jahaanb7/Orion/README.md

# Orion
Building a thrust-vector control rocket from scratch. It will include custom flight controller (useable for drones as well), thrust vector control mechanism, and our goal is for it to be actively stabilized and ascent ~30 meters into the air. 

Screenshot 2026-09-21 at 12 17 08 AM
Screenshot 2026-09-21 at 12 17 03 AM
Screenshot 2026-09-21 at 12 17 00 AM
Screenshot 2026-09-21 at 12 16 50 AM
