jahaanb7/Orion/CAD/Airframe/Body Tube.stl

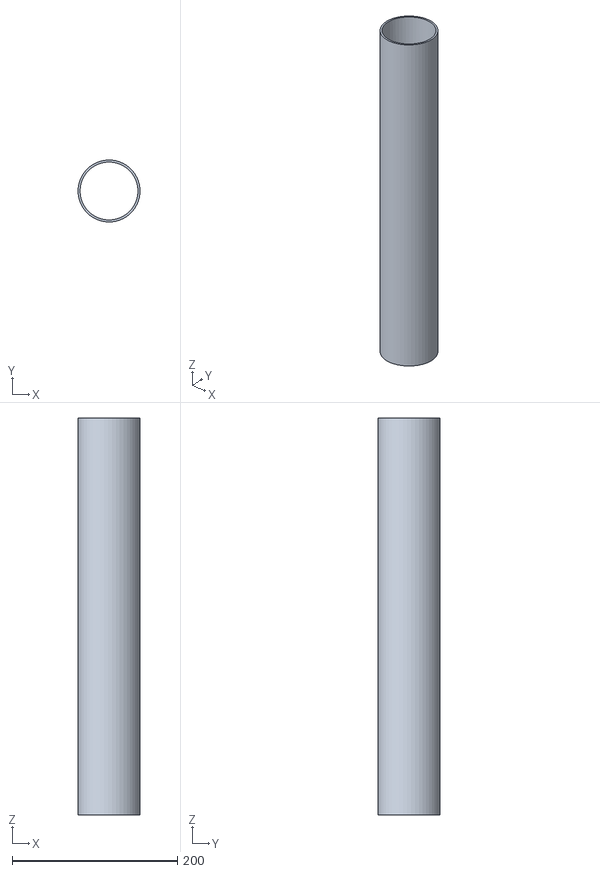
[picture p1: CAD file, 2026-09-21]
CAD/Airframe/Body Tube.stl
74.9 x 75.0 x 480.0
