jahaanb7/Orion/CAD/Nose Cone.stl

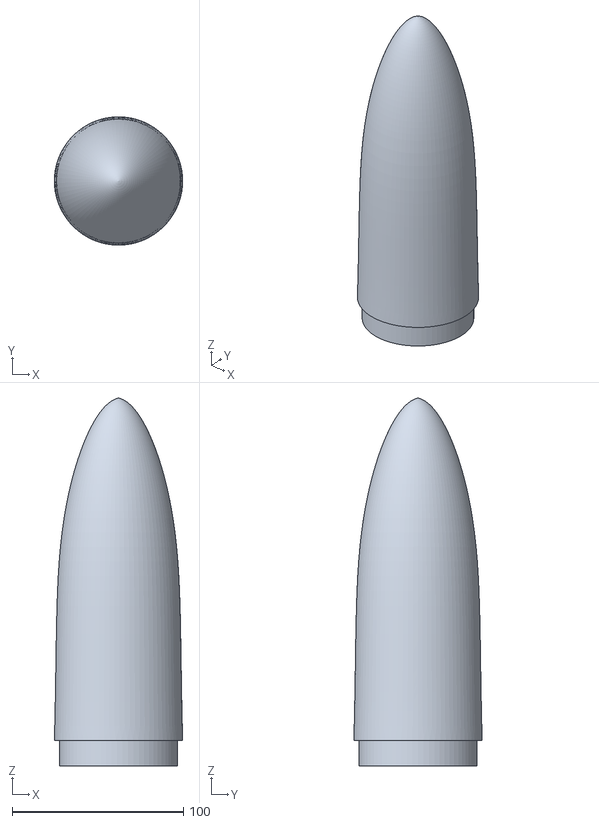
[picture p2: CAD file, 2026-09-21]
CAD/Nose Cone.stl
75.0 x 74.9 x 215.0
