jahaanb7/Orion/CAD/Airframe/Support Structure.stl

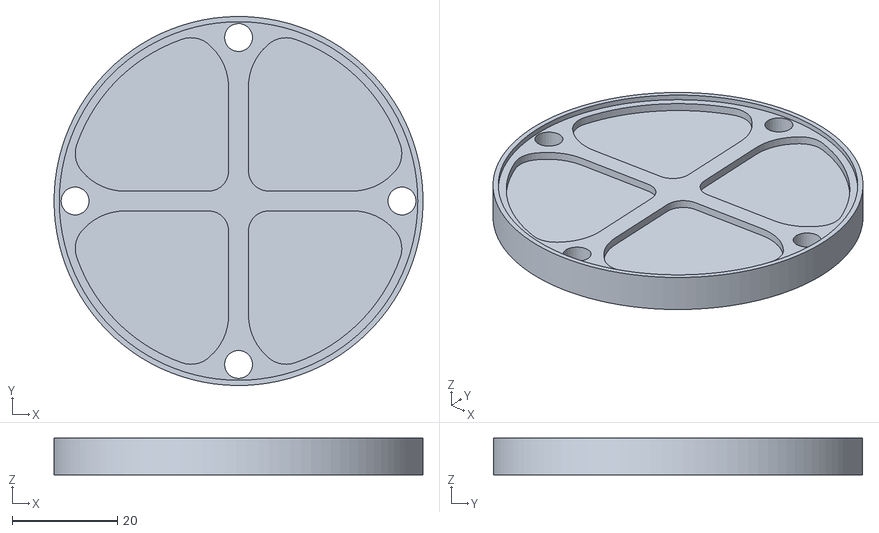
[picture p3: CAD file, 2026-09-21]
CAD/Airframe/Support Structure.stl
70.0 x 70.0 x 7.00
