jahaanb7/Orion/CAD/RocketMotor.stl

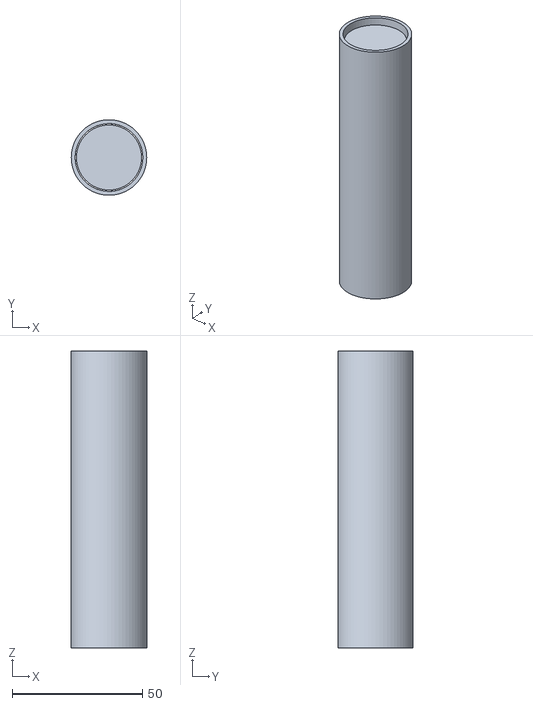
[picture p4: CAD file, 2026-09-21]
CAD/RocketMotor.stl
29.0 x 29.0 x 114.0
