jahaanb7/Orion/CAD/Airframe/Payload.stl

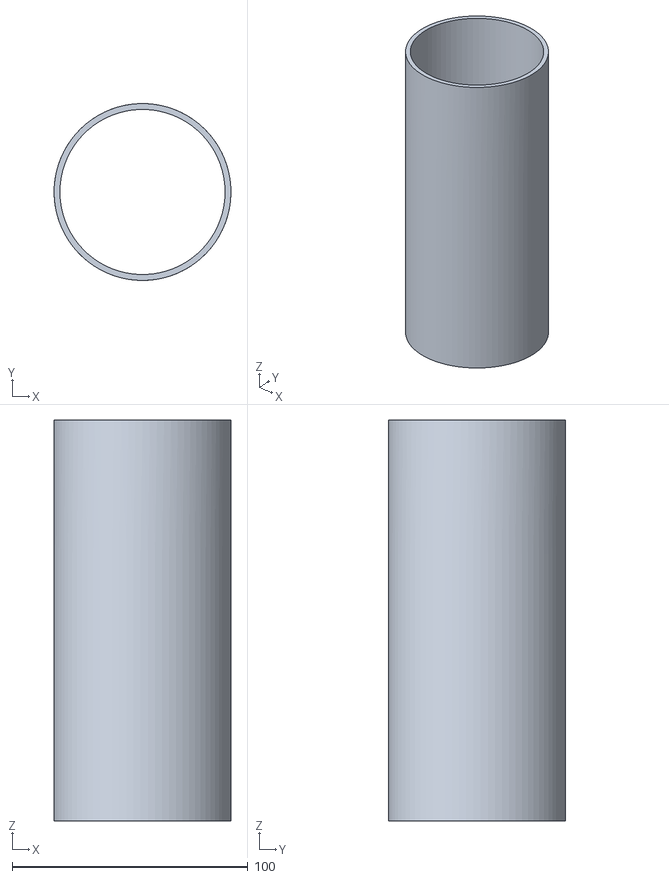
[picture p5: CAD file, 2026-09-21]
CAD/Airframe/Payload.stl
75.0 x 75.0 x 170.0
