jahaanb7/Orion/CAD/Orion_Master_V0.1.stl

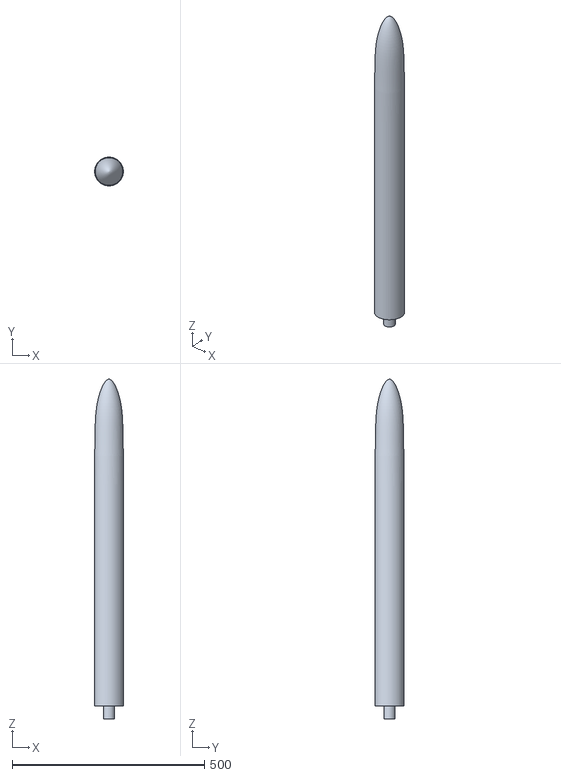
[picture p6: CAD file, 2026-09-21]
CAD/Orion_Master_V0.1.stl
75.0 x 75.0 x 884.0
