jahaanb7/Orion/CAD/Airframe/BaseMount.stl

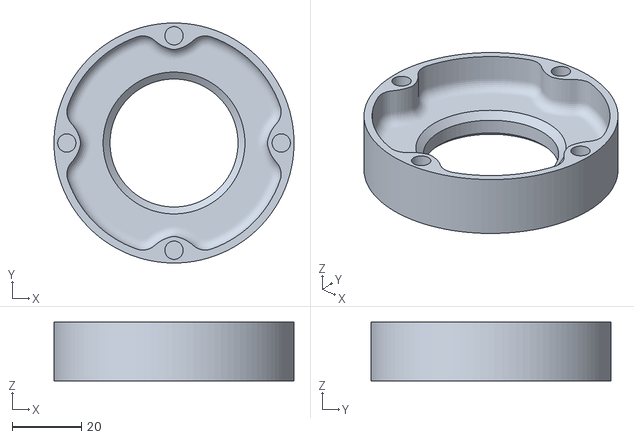
[picture p7: CAD file, 2026-09-21]
CAD/Airframe/BaseMount.stl
69.4 x 69.4 x 17.0
