jahaanb7/Orion/CAD/Airframe/Frame Structures.stl

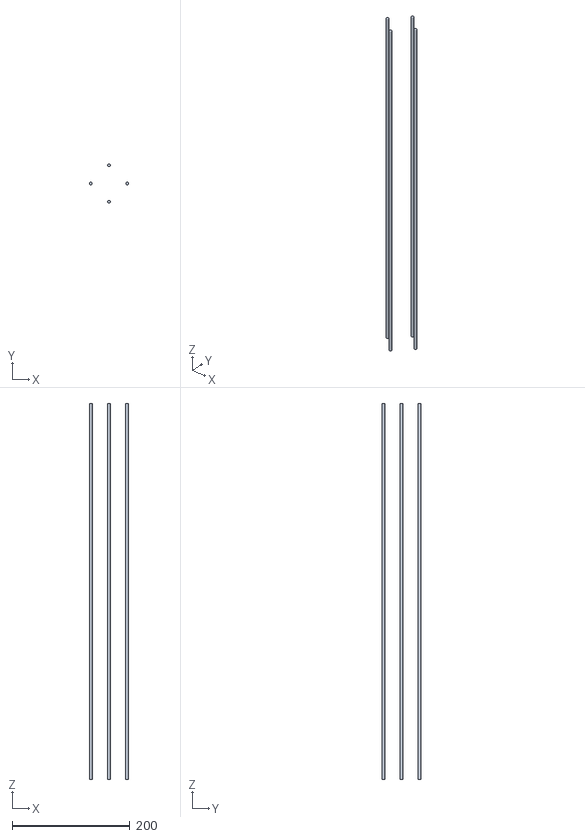
[picture p8: CAD file, 2026-09-21]
CAD/Airframe/Frame Structures.stl
67.0 x 67.0 x 640.0
