jahaanb7/Orion/JOURNAL.md

# Orion — Rocket Flight Controller — devlog

<!-- Generated by Half Life from project cmuw4bvp505uc01osaumad8f8. Edits here are overwritten on the next sync. -->
<!-- Generated: 1970-01-01T00:00:00.000Z -->

> [!NOTE]
> This devlog is mirrored from [Half Life](https://halflife.hackclub.com). Editing it here will not change the platform's copy, and the next sync overwrites this file.

> Custom flight controller for my thrust-vector controlled rocket: Rocket.

| Week | Tier | Hours logged | Entries |
| --- | --- | --- | --- |
| Week 1 | Tier 2 | 0h | 0 |

_No entries logged yet._
