jahaanb7/Orion/Schematic/FCC_Peripherals.kicad_sch

## KiCad design Schematic/FCC_Peripherals.kicad_sch (2026-09-21)

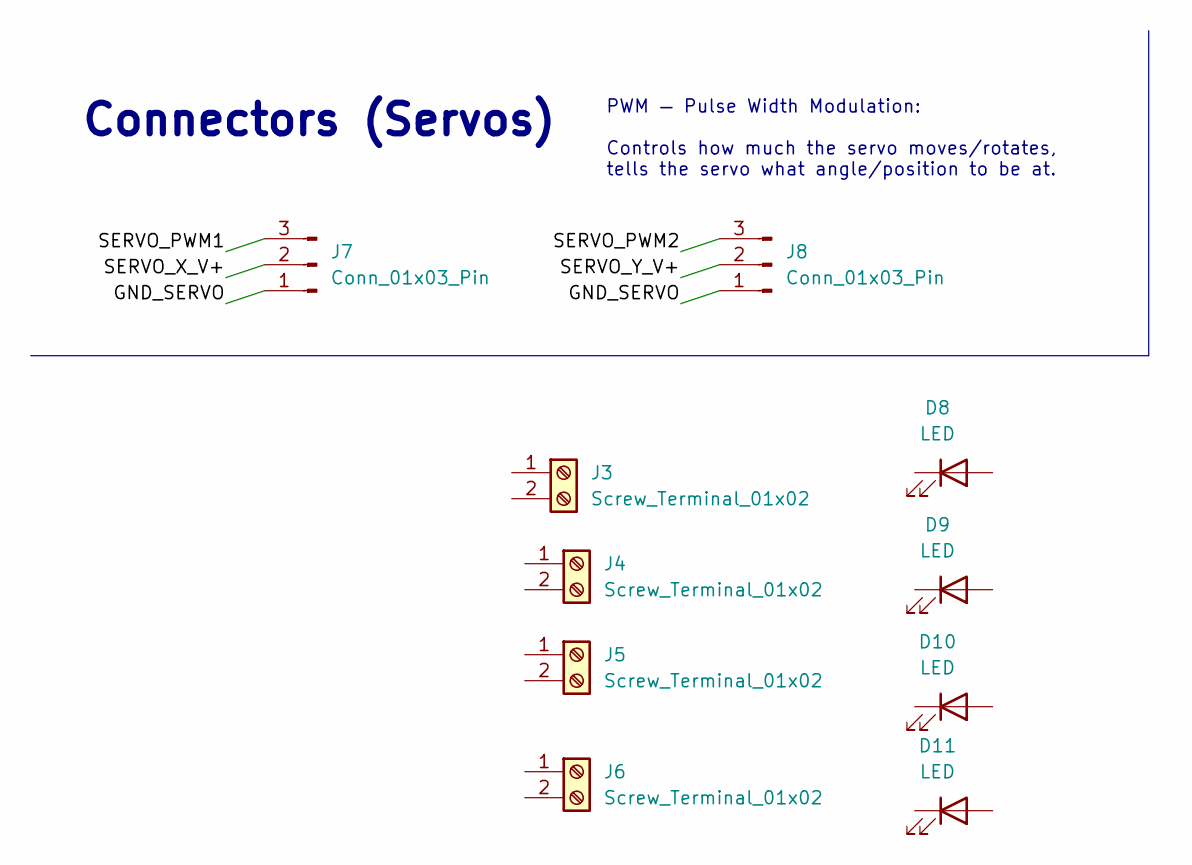
[picture p9: schematic FCC_Peripherals.kicad_sch]

Parts:
D8, D9, D10, D11: LED
J3, J4, J5, J6: Screw_Terminal_01x02
J7, J8: Conn_01x03_Pin

Connections:
GND_SERVO: J7.1, J8.1
SERVO_PWM1: J7.3
SERVO_PWM2: J8.3
SERVO_X_V+: J7.2
SERVO_Y_V+: J8.2

Notes on the sheet:
PWM — Pulse Width Modulation: Controls how much the servo moves/rotates, tells the servo what angle/position to be at.
Connectors (Servos)
