jahaanb7/Orion/Schematic/Flight-Compute-Module.kicad_sch

## KiCad design Schematic/Flight-Compute-Module.kicad_sch (2026-09-21)

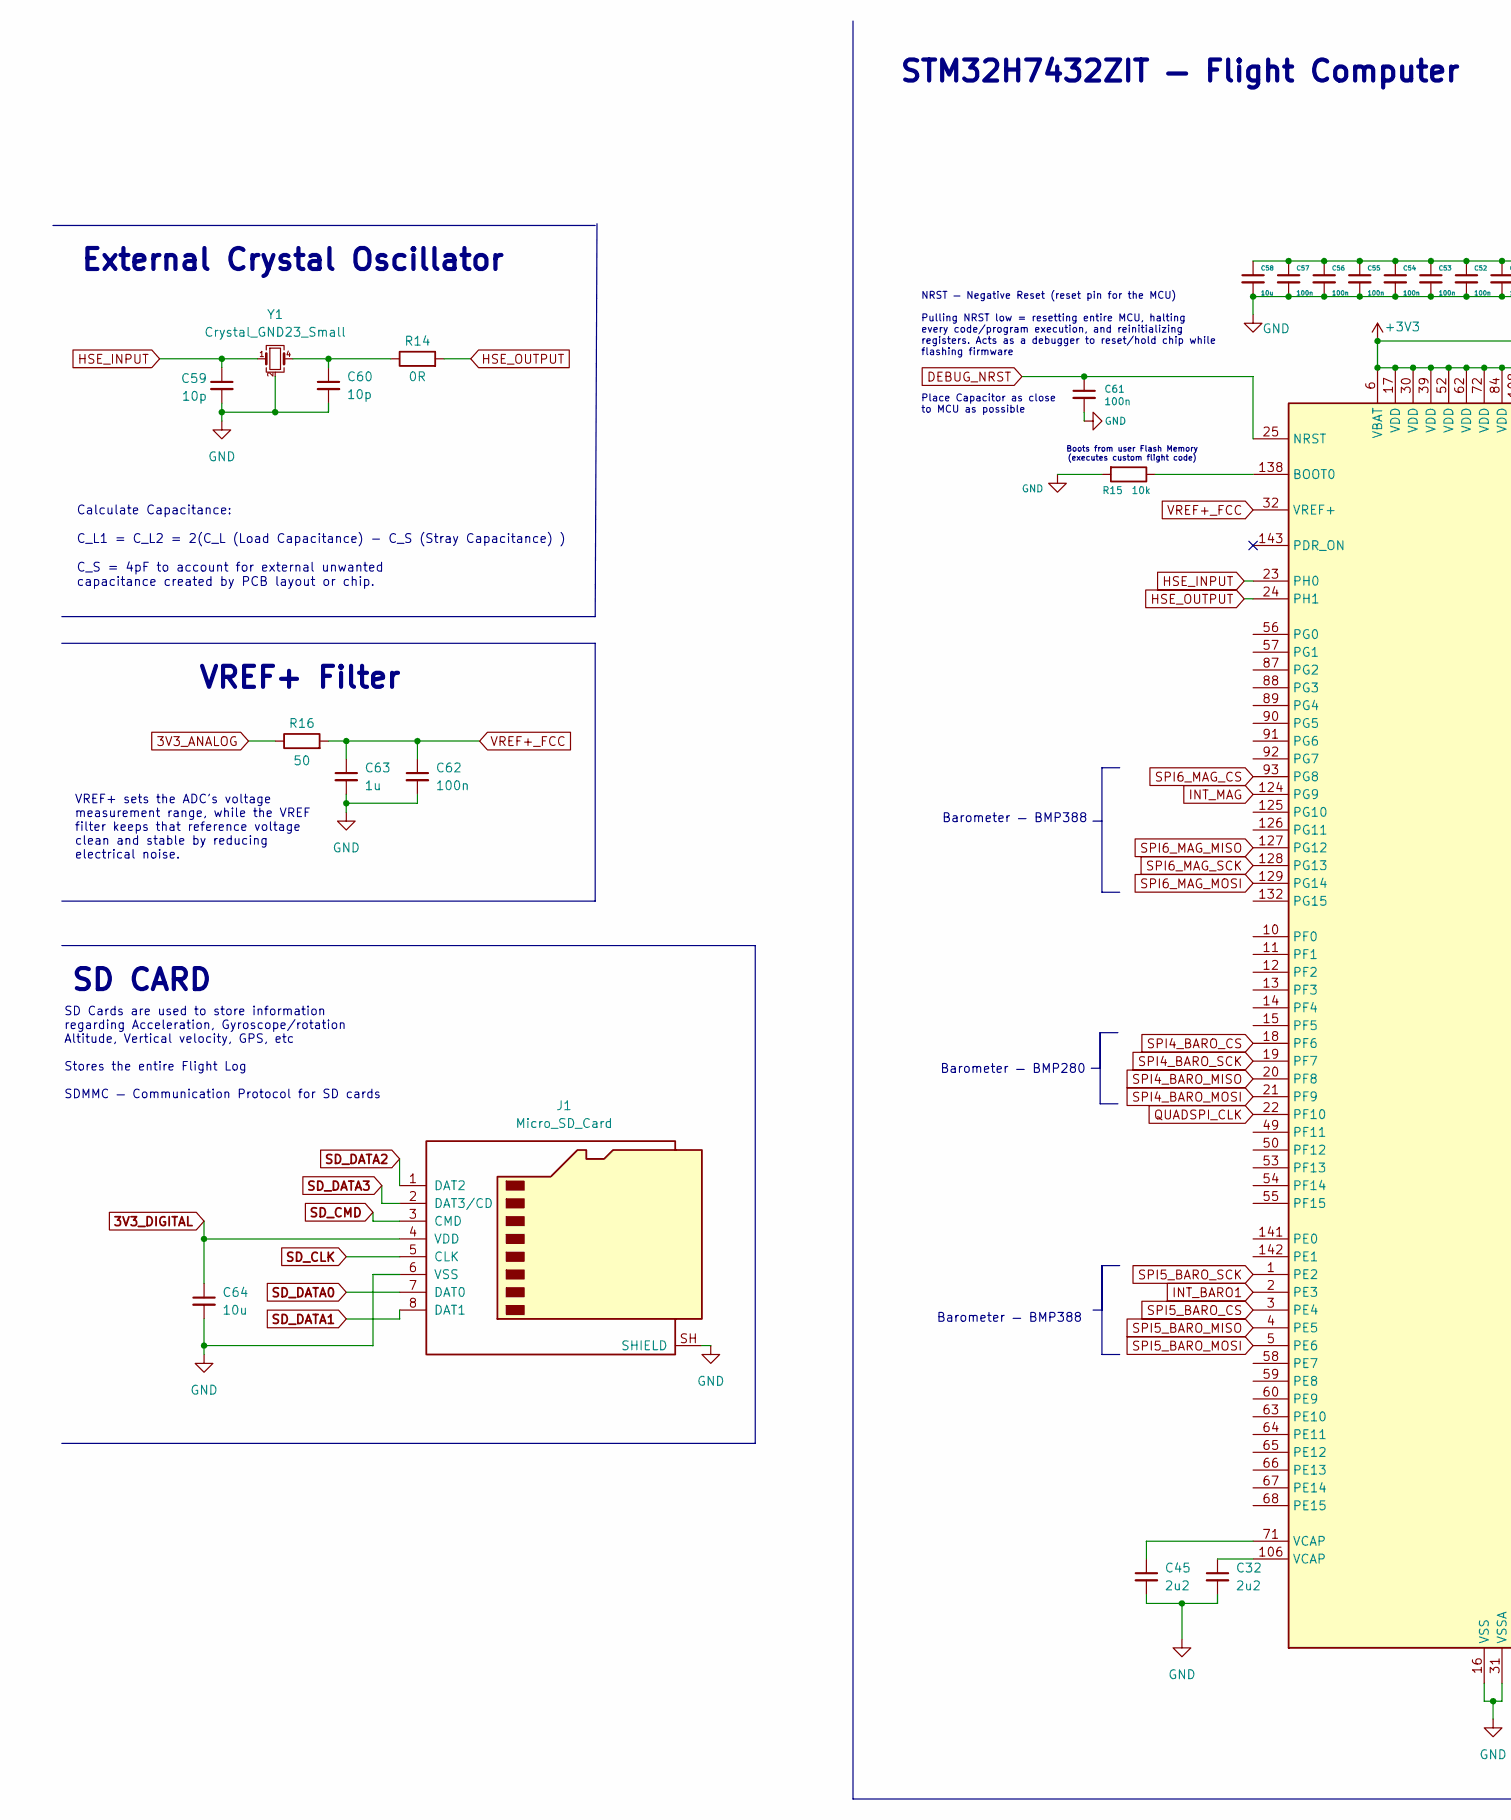
[picture p10: schematic Flight-Compute-Module.kicad_sch, part in row 1, column 1]

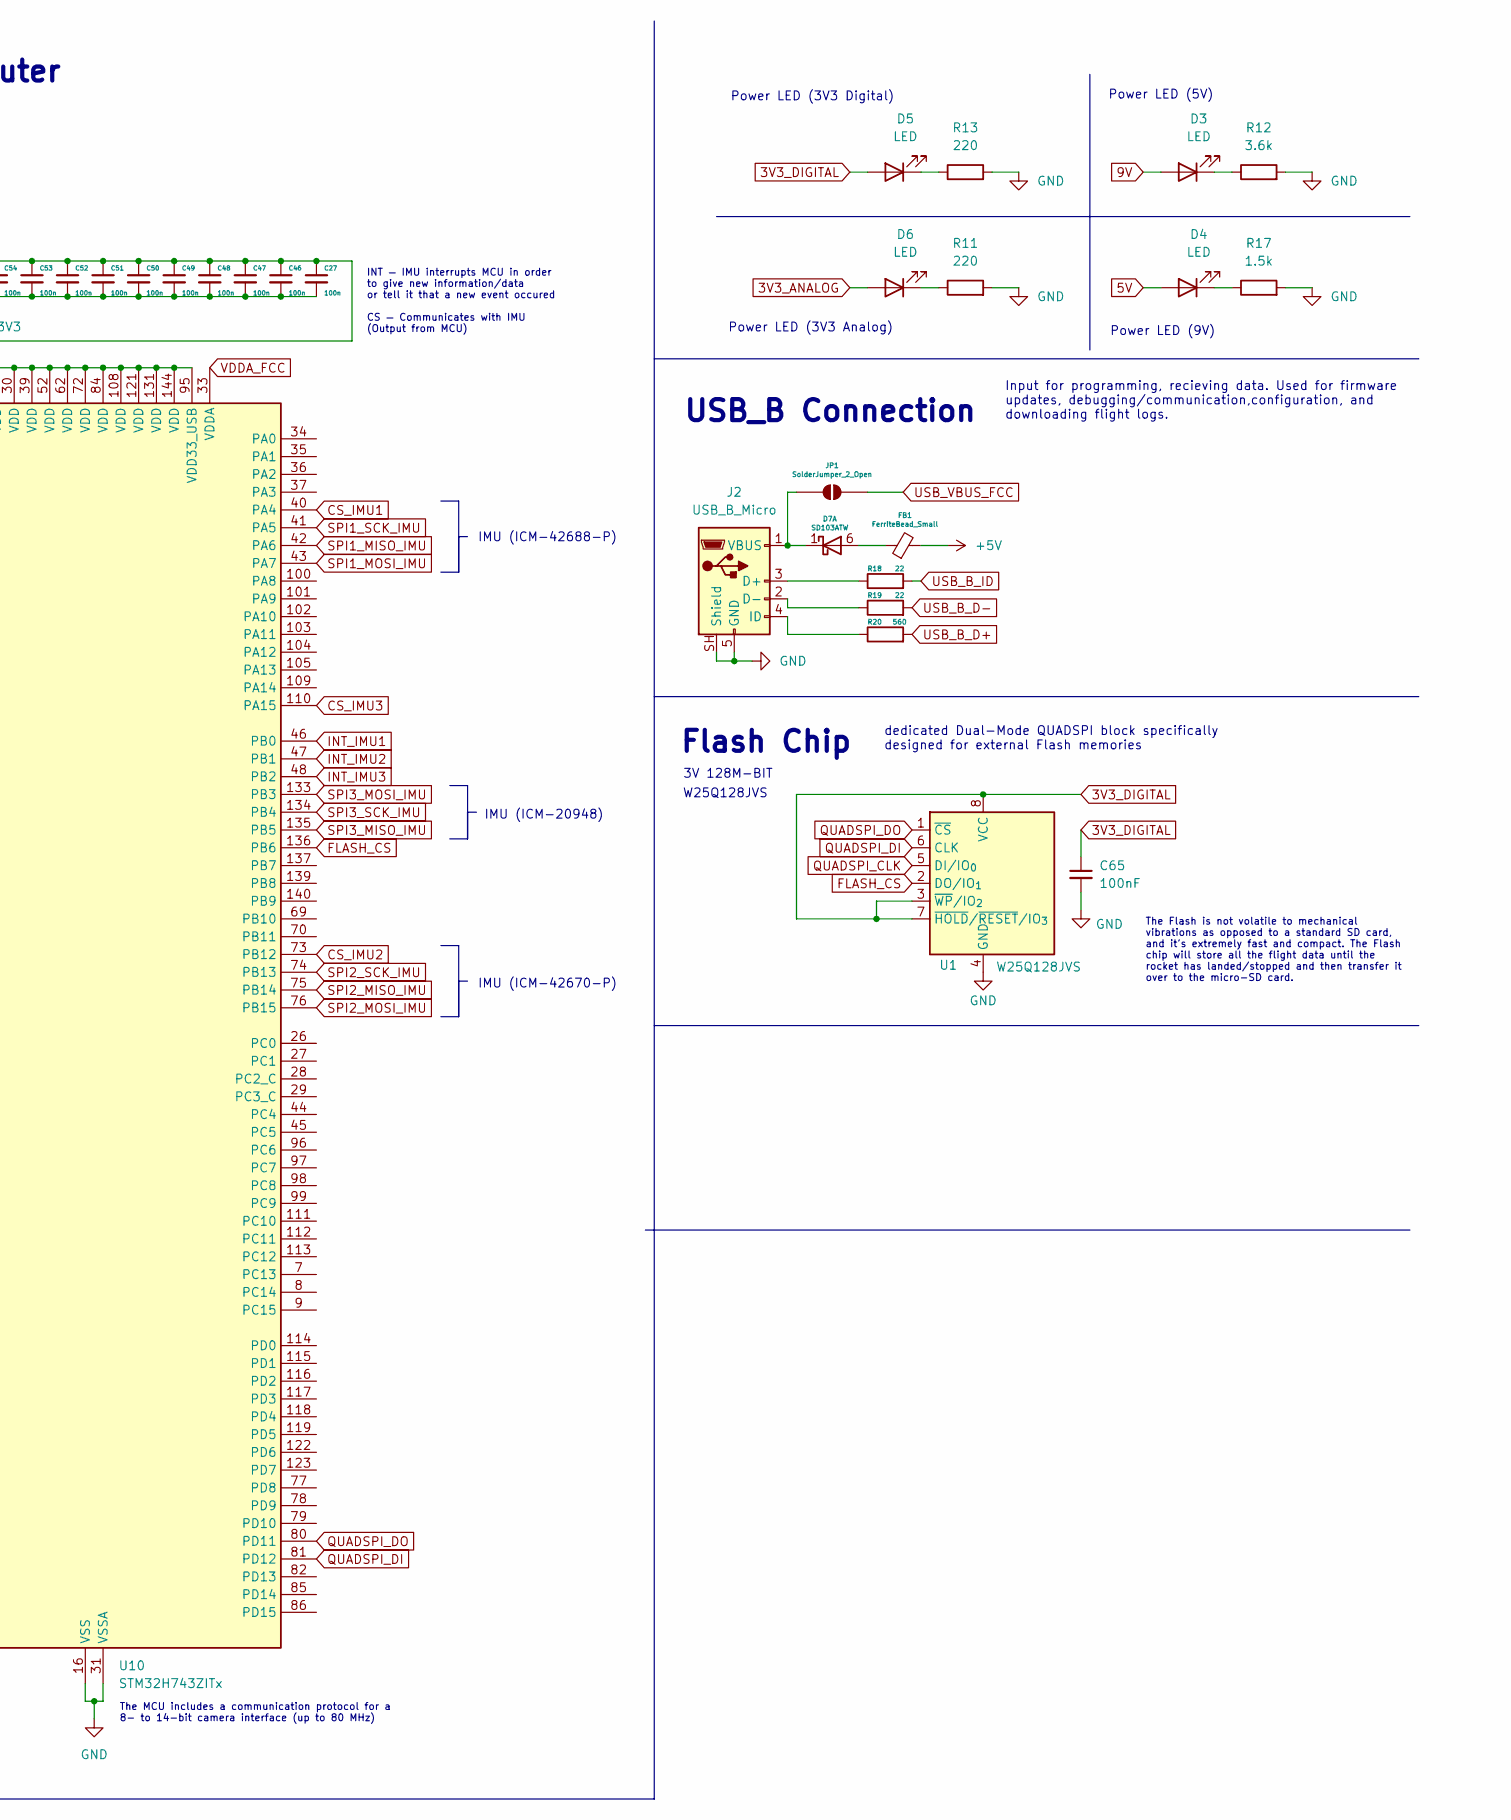
[picture p11: schematic Flight-Compute-Module.kicad_sch, part in row 1, column 2]

Parts:
C27, C46, C47, C48, C49, C50, C51, C52, C53, C54, C55, C56, C57, C61, C62: 100n
C32, C45: 2u2
C58, C64: 10u
C59, C60: 10p
C63: 1u
C65: 100nF
D3, D4, D5, D6: LED
D7: SD103ATW; SOT-363_SC-70-6
FB1: FerriteBead_Small
J1: Micro_SD_Card
J2: USB_B_Micro
JP1: SolderJumper_2_Open
R11, R13: 220
R12: 3.6k
R14: 0R
R15: 10k
R16: 50
R17: 1.5k
R18, R19: 22
R20: 560
U1: W25Q128JVS; SOIC-8_5.3x5.3mm_P1.27mm
U10: STM32H743ZITx; LQFP-144_20x20mm_P0.5mm
Y1: Crystal_GND23_Small

Connections:
3V3_ANALOG: D6.2 (A), R16.1
3V3_DIGITAL: C64.1, C65.1, D5.2 (A), J1.4 (VDD), U1.3 (~WP/IO_{2}), U1.7 (~HOLD/~RESET/IO_{3}), U1.8 (VCC)
5V: D4.2 (A)
9V: D3.2 (A)
+3V3: C27.1, C46.1, C47.1, C48.1, C49.1, C50.1, C51.1, C52.1, C53.1, C54.1, C55.1, C56.1, C57.1, C58.1, U10.6 (VBAT), U10.17 (VDD), U10.30 (VDD), U10.39 (VDD), U10.52 (VDD), U10.62 (VDD), U10.72 (VDD), U10.84 (VDD), U10.95 (VDD33_USB), U10.108 (VDD), U10.121 (VDD), U10.131 (VDD), U10.144 (VDD)
+5V: FB1.2
CS_IMU1: U10.40 (PA4)
CS_IMU2: U10.73 (PB12)
CS_IMU3: U10.110 (PA15)
DEBUG_NRST: C61.1, U10.25 (NRST)
FLASH_CS: U1.2 (DO/IO_{1}), U10.136 (PB6)
GND: C27.2, C32.2, C45.2, C46.2, C47.2, C48.2, C49.2, C50.2, C51.2, C52.2, C53.2, C54.2, C55.2, C56.2, C57.2, C58.2, C59.2, C60.2, C61.2, C62.2, C63.2, C64.2, C65.2, J1.6 (VSS), J1.SH (SHIELD), J2.5 (GND), J2.SH (Shield), R11.2, R12.2, R13.2, R15.2, R17.2, U1.4 (GND), U10.16 (VSS), U10.31 (VSSA), U10.38 (VSS), U10.51 (VSS), U10.61 (VSS), U10.83 (VSS), U10.94 (VSS), U10.107 (VSS), U10.120 (VSS), U10.130 (VSS), Y1.2 (G), Y1.3 (G)
HSE_INPUT: C59.1, U10.23 (PH0), Y1.1
HSE_OUTPUT: R14.2, U10.24 (PH1)
INT_BARO1: U10.2 (PE3)
INT_IMU1: U10.46 (PB0)
INT_IMU2: U10.47 (PB1)
INT_IMU3: U10.48 (PB2)
INT_MAG: U10.124 (PG9)
unnamed: C32.1, U10.106 (VCAP)
unnamed: C45.1, U10.71 (VCAP)
unnamed: C60.1, R14.1, Y1.4
unnamed: D3.1 (K), R12.1
unnamed: D4.1 (K), R17.1
unnamed: D5.1 (K), R13.1
unnamed: D6.1 (K), R11.1
unnamed: D7.1 (K), J2.1 (VBUS), JP1.1 (A)
unnamed: D7.6 (A), FB1.1
unnamed: J2.2 (D-), R19.1
unnamed: J2.3 (D+), R18.1
unnamed: J2.4 (ID), R20.1
unnamed: R15.1, U10.138 (BOOT0)
QUADSPI_CLK: U1.5 (DI/IO_{0}), U10.22 (PF10)
QUADSPI_DI: U1.6 (CLK), U10.81 (PD12)
QUADSPI_DO: U1.1 (~CS), U10.80 (PD11)
SD_CLK: J1.5 (CLK)
SD_CMD: J1.3 (CMD)
SD_DATA0: J1.7 (DAT0)
SD_DATA1: J1.8 (DAT1)
SD_DATA2: J1.1 (DAT2)
SD_DATA3: J1.2 (DAT3/CD)
SPI1_MISO_IMU: U10.42 (PA6)
SPI1_MOSI_IMU: U10.43 (PA7)
SPI1_SCK_IMU: U10.41 (PA5)
SPI2_MISO_IMU: U10.75 (PB14)
SPI2_MOSI_IMU: U10.76 (PB15)
SPI2_SCK_IMU: U10.74 (PB13)
SPI3_MISO_IMU: U10.135 (PB5)
SPI3_MOSI_IMU: U10.133 (PB3)
SPI3_SCK_IMU: U10.134 (PB4)
SPI4_BARO_CS: U10.18 (PF6)
SPI4_BARO_MISO: U10.20 (PF8)
SPI4_BARO_MOSI: U10.21 (PF9)
SPI4_BARO_SCK: U10.19 (PF7)
SPI5_BARO_CS: U10.3 (PE4)
SPI5_BARO_MISO: U10.4 (PE5)
SPI5_BARO_MOSI: U10.5 (PE6)
SPI5_BARO_SCK: U10.1 (PE2)
SPI6_MAG_CS: U10.93 (PG8)
SPI6_MAG_MISO: U10.127 (PG12)
SPI6_MAG_MOSI: U10.129 (PG14)
SPI6_MAG_SCK: U10.128 (PG13)
USB_B_D+: R20.2
USB_B_D-: R19.2
USB_B_ID: R18.2
USB_VBUS_FCC: JP1.2 (B)
VDDA_FCC: U10.33 (VDDA)
VREF+_FCC: C62.1, C63.1, R16.2, U10.32 (VREF+)

Notes on the sheet:
NRST — Negative Reset (reset pin for the MCU) Pulling NRST low = resetting entire MCU, halting every code/program execution, and reinitializing registers. Acts as a debugger to reset/hold chip while flashing firmware
3V 128M-BIT
The Flash is not volatile to mechanical vibrations as opposed to a standard SD card, and it's extremely fast and compact. The Flash chip will store all the flight data until the rocket has landed/stopped and then transfer it over to the micro-SD card.
VREF+ Filter
INT — IMU interrupts MCU in order to give new information/data or tell it that a new event occured CS — Communicates with IMU (Output from MCU)
Barometer — BMP388
USB_B Connection
Flash Chip
IMU (ICM-42670-P)
Power LED (3V3 Digital)
External Crystal Oscillator
dedicated Dual-Mode QUADSPI block specifically designed for external Flash memories
Place Capacitor as close to MCU as possible
Power LED (9V)
IMU (ICM-20948)
Power LED (3V3 Analog)
Barometer — BMP280
Power LED (5V)
Calculate Capacitance: C_L1 = C_L2 = 2(C_L (Load Capacitance) - C_S (Stray Capacitance) ) C_S = 4pF to account for external unwanted capacitance created by PCB layout or chip.
SD CARD
W25Q128JVS
SD Cards are used to store information regarding Acceleration, Gyroscope/rotation Altitude, Vertical velocity, GPS, etc Stores the entire Flight Log SDMMC — Communication Protocol for SD cards
STM32H7432ZIT — Flight Computer
Barometer — BMP388
Boots from user Flash Memory (executes custom flight code)
VREF+ sets the ADC's voltage measurement range, while the VREF filter keeps that reference voltage clean and stable by reducing electrical noise.
The MCU includes a communication protocol for a 8- to 14-bit camera interface (up to 80 MHz)
IMU (ICM-42688-P)
Input for programming, recieving data. Used for firmware updates, debugging/communication,configuration, and downloading flight logs.
