jahaanb7/Orion/Schematic/FlightController.kicad_sch

## KiCad design Schematic/FlightController.kicad_sch (2026-09-14)

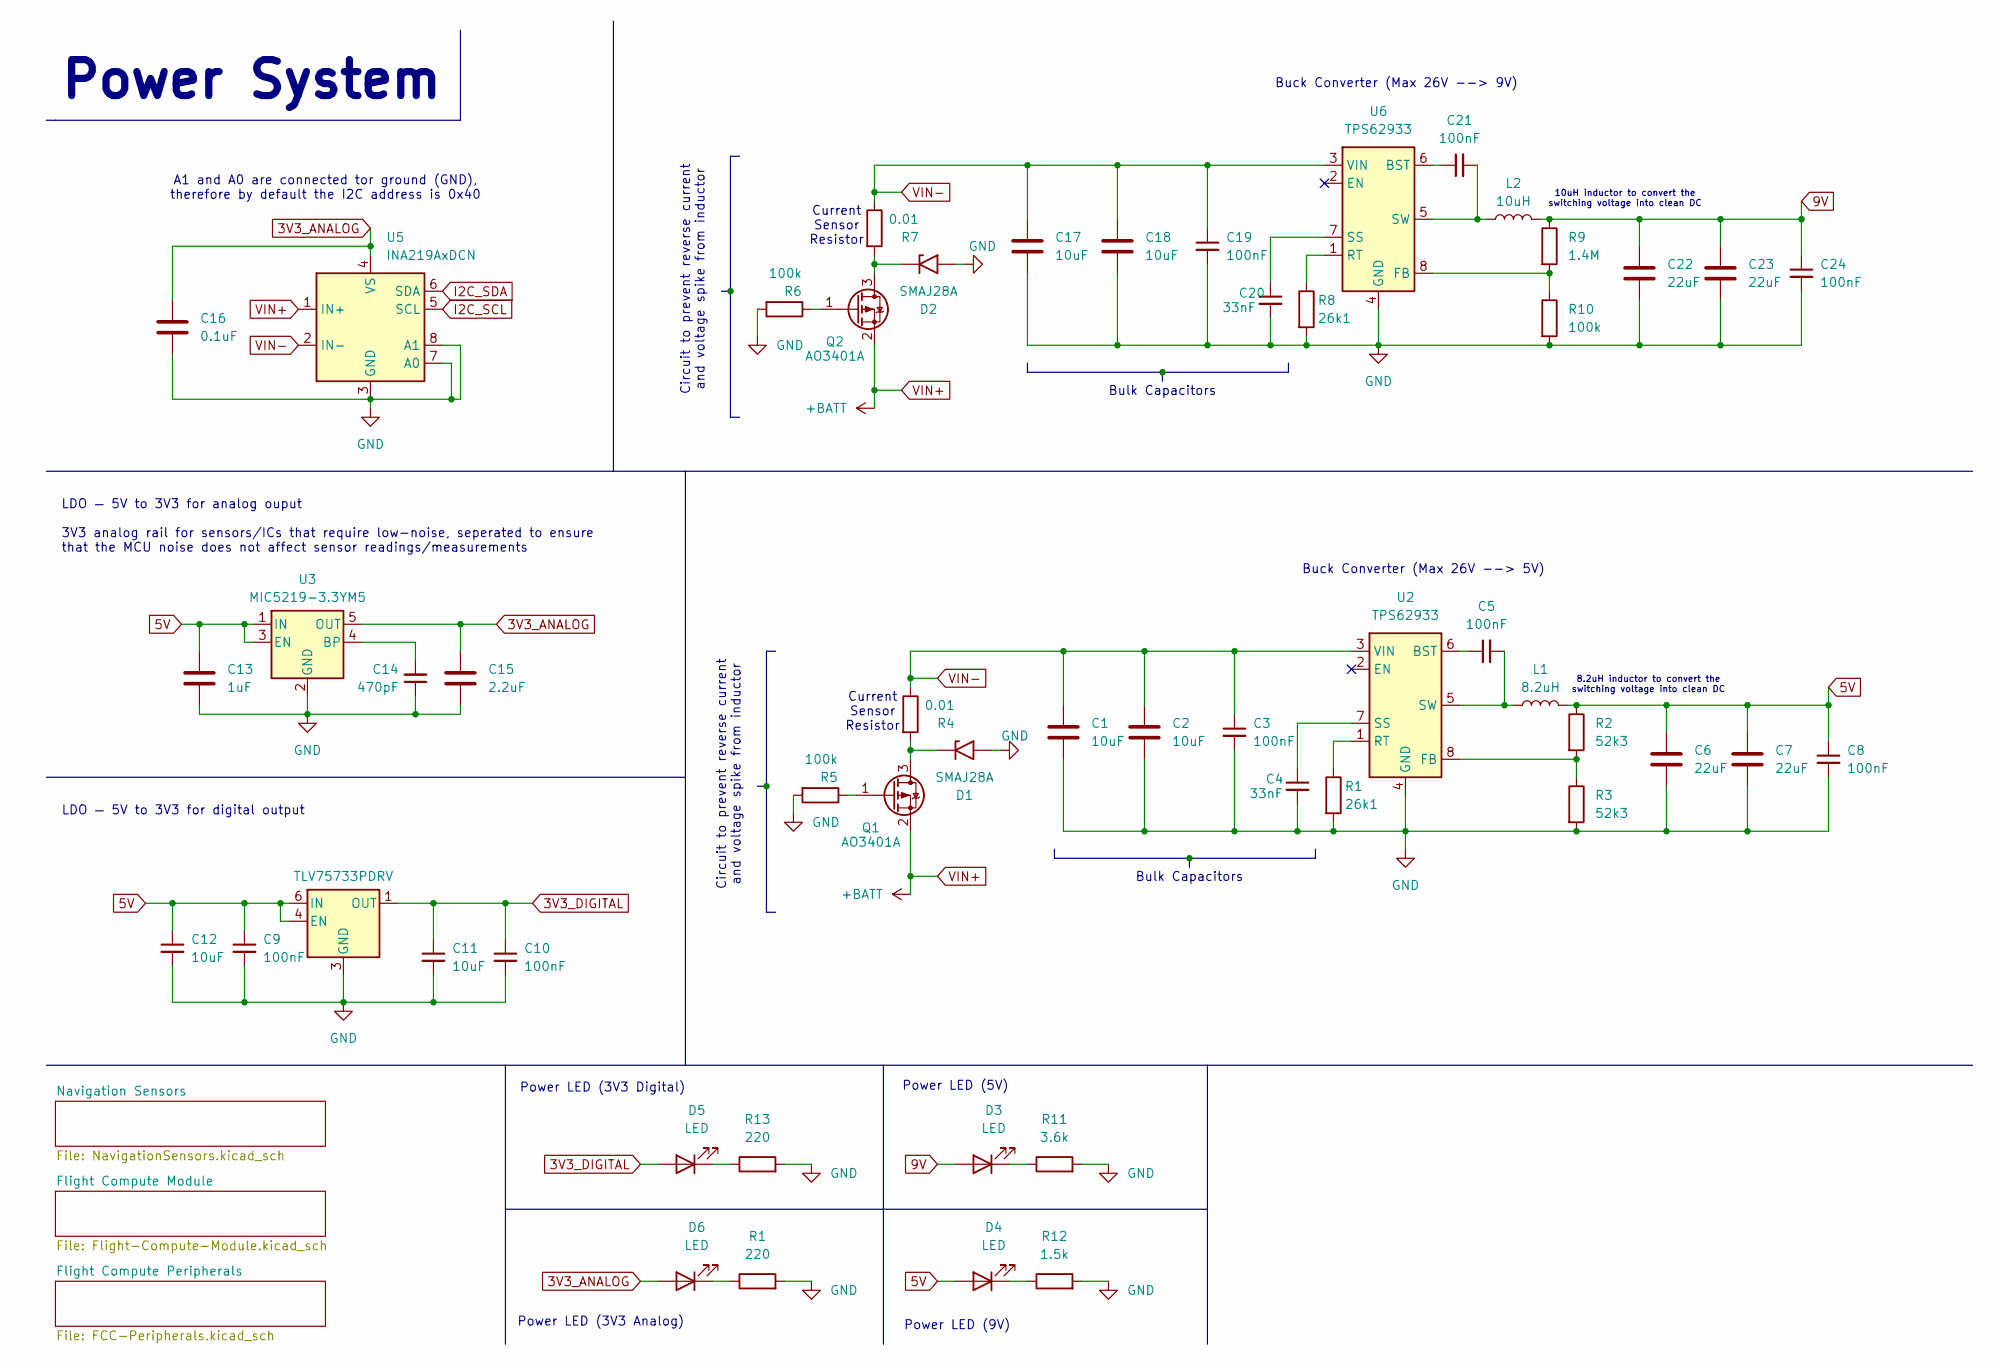
[picture p12: schematic FlightController.kicad_sch]

Parts:
C1, C2, C11, C12, C17, C18: 10uF
C3, C5, C8, C9, C10, C19, C21, C24: 100nF
C4, C20: 33nF
C6, C7, C22, C23: 22uF
C13: 1uF
C14: 470pF
C15: 2.2uF
C16: 0.1uF
D1, D2: SMAJ28A; D_SMA
D3, D4, D5, D6: LED
L1: 8.2uH
L2: 10uH
Q1, Q2: AO3401A; SOT-23
R1, R13: 220
R2, R3: 52k3
R4, R7: 0.01
R5, R6, R10: 100k
R8: 26k1
R9: 1.4M
R11: 3.6k
R12: 1.5k
U2, U6: TPS62933; SOT-583-8
U3: MIC5219-3.3YM5; SOT-23-5
U4: TLV75733PDRV; WSON-6-1EP_2x2mm_P0.65mm_EP1x1.6mm
U5: INA219AxDCN; SOT-23-8

Connections:
3V3_ANALOG: C15.1, C16.1, D6.2 (A), U3.5 (OUT), U5.4 (VS)
3V3_DIGITAL: C10.1, C11.1, D5.2 (A), U4.1 (OUT)
5V: C6.1, C7.1, C8.1, C9.1, C12.1, C13.1, D4.2 (A), L1.2, R2.1, U3.1 (IN), U3.3 (EN), U4.4 (EN), U4.6 (IN)
9V: C22.1, C23.1, C24.1, D3.2 (A), L2.2, R9.1
+BATT: Q1.2 (S), Q2.2 (S), U5.1 (IN+)
GND: C1.2, C2.2, C3.2, C4.2, C6.2, C7.2, C8.2, C9.2, C10.2, C11.2, C12.2, C13.2, C14.1, C15.2, C16.2, C17.2, C18.2, C19.2, C20.2, C22.2, C23.2, C24.2, D1.2 (A2), D2.2 (A2), R1.2, R3.2, R5.2, R6.2, R8.2, R10.2, R11.2, R12.2, R13.2, U2.4 (GND), U3.2 (GND), U4.3 (GND), U4.7 (GND), U5.3 (GND), U5.7 (A0), U5.8 (A1), U6.4 (GND)
I2C_SCL: U5.5 (SCL)
I2C_SDA: U5.6 (SDA)
unnamed: C4.1, U2.7 (SS)
unnamed: C5.1, U2.6 (BST)
unnamed: C5.2, L1.1, U2.5 (SW)
unnamed: C14.2, U3.4 (BP)
unnamed: C20.1, U6.7 (SS)
unnamed: C21.1, U6.6 (BST)
unnamed: C21.2, L2.1, U6.5 (SW)
unnamed: D1.1 (A1), Q1.3 (D), R4.2
unnamed: D2.1 (A1), Q2.3 (D), R7.2
unnamed: D3.1 (K), R11.1
unnamed: D4.1 (K), R12.1
unnamed: D5.1 (K), R13.1
unnamed: D6.1 (K), R1.1
unnamed: Q1.1 (G), R5.1
unnamed: Q2.1 (G), R6.1
unnamed: R1.1, U2.1 (RT)
unnamed: R2.2, R3.1, U2.8 (FB)
unnamed: R8.1, U6.1 (RT)
unnamed: R9.2, R10.1, U6.8 (FB)
VIN-: C1.1, C2.1, C3.1, C17.1, C18.1, C19.1, R4.1, R7.1, U2.3 (VIN), U5.2 (IN-), U6.3 (VIN)

Notes on the sheet:
Circuit to prevent reverse current and voltage spike from inductor
A1 and A0 are connected tor ground (GND), therefore by default the I2C address is 0x40
Power LED (3V3 Analog)
8.2uH inductor to convert the switching voltage into clean DC
10uH inductor to convert the switching voltage into clean DC
LDO — 5V to 3V3 for analog ouput 3V3 analog rail for sensors/ICs that require low-noise, seperated to ensure that the MCU noise does not affect sensor readings/measurements
Current Sensor Resistor
Power LED (9V)
Buck Converter (Max 26V --> 5V)
Power LED (5V)
LDO — 5V to 3V3 for digital output
Buck Converter (Max 26V --> 9V)
Power System
Power LED (3V3 Digital)
Bulk Capacitors
