jahaanb7/Orion/Schematic/NavigationSensors.kicad_sch

## KiCad design Schematic/NavigationSensors.kicad_sch (2026-09-21)

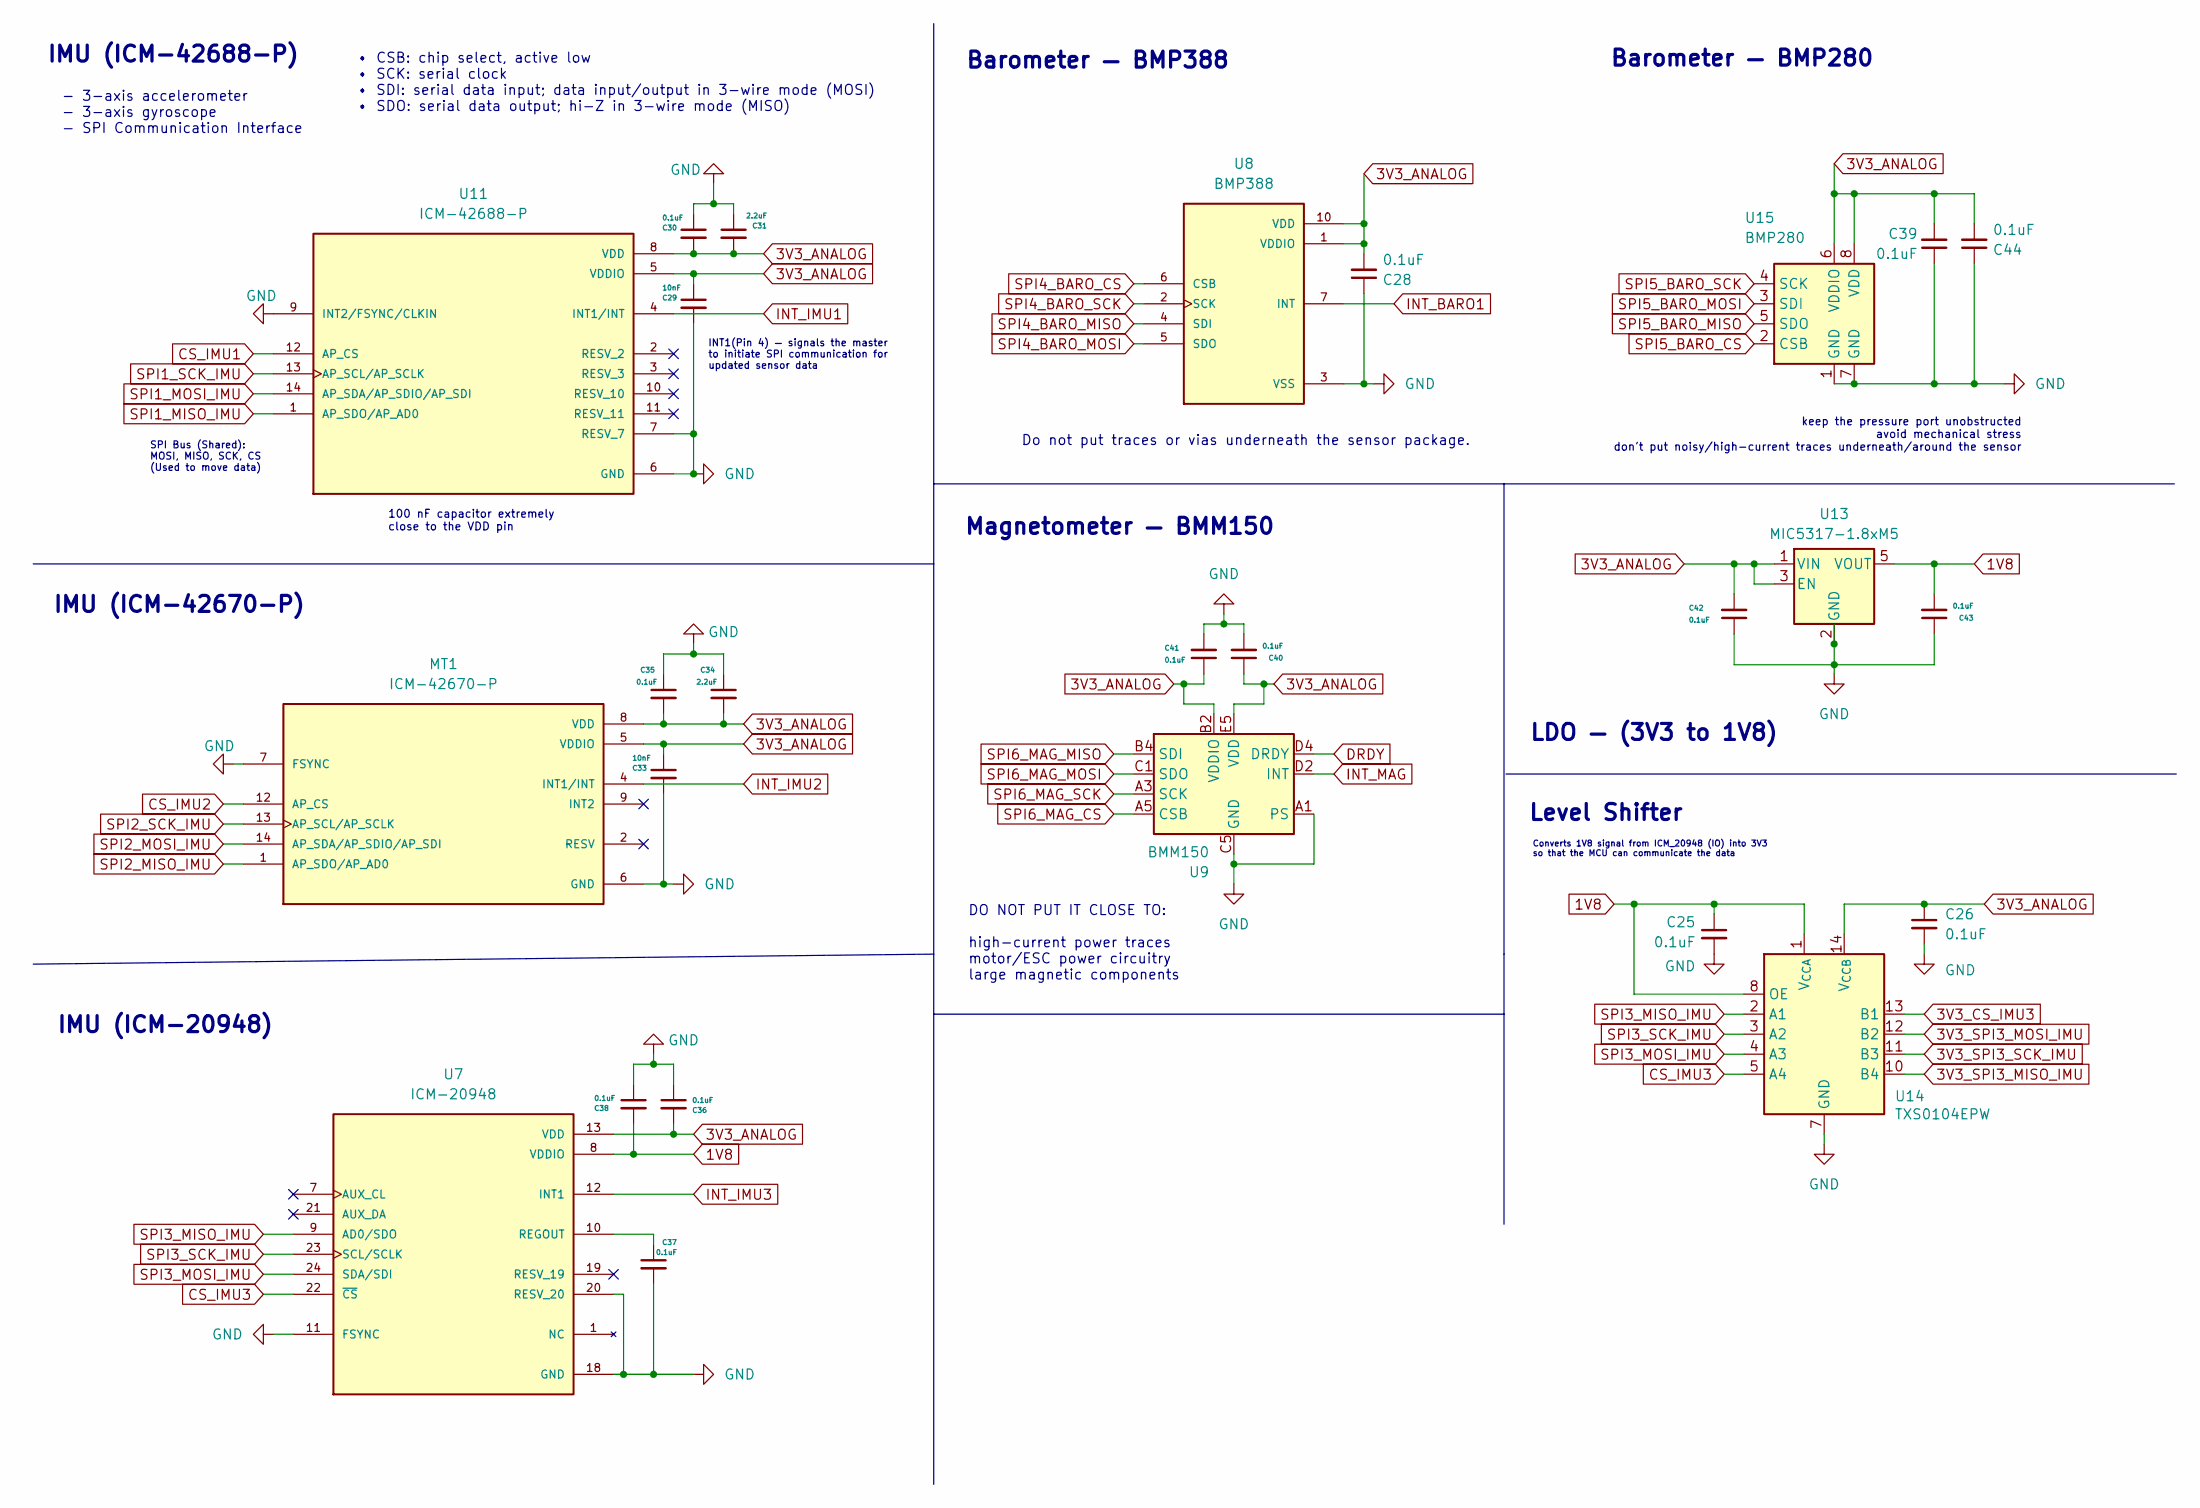
[picture p13: schematic NavigationSensors.kicad_sch]

Parts:
C25, C26, C28, C30, C35, C36, C37, C38, C39, C40, C41, C42, C43, C44: 0.1uF
C29, C33: 10nF
C31, C34: 2.2uF
MT1: ICM-42670-P; XDCR_ICM-42670-P; PARTREV 1.1
U7: ICM-20948; QFN40P300X300X105-24N; PARTREV 1.3
U8: BMP388; XDCR_BMP388; PARTREV 1.7; DigiKey_Part_Number 828-1079-2-ND
U9: BMM150; WLCSP-12_1.56x1.56mm_P0.4mm
U11: ICM-42688-P; PQFN50P300X250X97-14N; PARTREV 1.2; DigiKey_Part_Number 1428-ICM-42688-PCT-ND
U13: MIC5317-1.8xM5; SOT-23-5
U14: TXS0104EPW; TSSOP-14_4.4x5mm_P0.65mm
U15: BMP280; Bosch_LGA-8_2x2.5mm_P0.65mm_ClockwisePinNumbering

Connections:
1V8: C25.1, C38.2, C43.2, U7.8 (VDDIO), U13.5 (VOUT), U14.1 (V_{CCA}), U14.8 (OE)
3V3_ANALOG: C26.1, C28.2, C29.1, C30.2, C31.2, C33.1, C34.2, C35.2, C36.2, C39.2, C40.1, C41.1, C42.2, C44.2, MT1.5 (VDDIO), MT1.8 (VDD), U7.13 (VDD), U8.1 (VDDIO), U8.10 (VDD), U9.B2 (VDDIO), U9.E5 (VDD), U11.5 (VDDIO), U11.8 (VDD), U13.1 (VIN), U13.3 (EN), U14.14 (V_{CCB}), U15.6 (VDDIO), U15.8 (VDD)
3V3_CS_IMU3: U14.13 (B1)
3V3_SPI3_MISO_IMU: U14.10 (B4)
3V3_SPI3_MOSI_IMU: U14.12 (B2)
3V3_SPI3_SCK_IMU: U14.11 (B3)
CS_IMU1: U11.12 (AP_CS)
CS_IMU2: MT1.12 (AP_CS)
CS_IMU3: U7.22 (~CS), U14.5 (A4)
DRDY: U9.D4 (DRDY)
GND: C25.2, C26.2, C28.1, C29.2, C30.1, C31.1, C33.2, C34.1, C35.1, C36.1, C37.2, C38.1, C39.1, C40.2, C41.2, C42.1, C43.1, C44.1, MT1.6 (GND), MT1.7 (FSYNC), U7.11 (FSYNC), U7.18 (GND), U7.20 (RESV_20), U8.3 (VSS), U8.8 (VSS), U8.9 (VSS), U9.A1 (PS), U9.C5 (GND), U9.E1 (GND), U9.E3 (GND), U11.6 (GND), U11.7 (RESV_7), U11.9 (INT2/FSYNC/CLKIN), U13.2 (GND), U14.7 (GND), U15.1 (GND), U15.7 (GND)
INT_BARO1: U8.7 (INT)
INT_IMU1: U11.4 (INT1/INT)
INT_IMU2: MT1.4 (INT1/INT)
INT_IMU3: U7.12 (INT1)
INT_MAG: U9.D2 (INT)
unnamed: C37.1, U7.10 (REGOUT)
unnamed: MT1.2 (RESV), MT1.3 (RESV), MT1.10 (RESV), MT1.11 (RESV)
unnamed: U7.1 (NC), U7.2 (NC), U7.3 (NC), U7.4 (NC), U7.5 (NC), U7.6 (NC), U7.14 (NC), U7.15 (NC), U7.16 (NC), U7.17 (NC)
SPI1_MISO_IMU: U11.1 (AP_SDO/AP_AD0)
SPI1_MOSI_IMU: U11.14 (AP_SDA/AP_SDIO/AP_SDI)
SPI1_SCK_IMU: U11.13 (AP_SCL/AP_SCLK)
SPI2_MISO_IMU: MT1.1 (AP_SDO/AP_AD0)
SPI2_MOSI_IMU: MT1.14 (AP_SDA/AP_SDIO/AP_SDI)
SPI2_SCK_IMU: MT1.13 (AP_SCL/AP_SCLK)
SPI3_MISO_IMU: U7.9 (AD0/SDO), U14.2 (A1)
SPI3_MOSI_IMU: U7.24 (SDA/SDI), U14.4 (A3)
SPI3_SCK_IMU: U7.23 (SCL/SCLK), U14.3 (A2)
SPI4_BARO_CS: U8.6 (CSB)
SPI4_BARO_MISO: U8.4 (SDI)
SPI4_BARO_MOSI: U8.5 (SDO)
SPI4_BARO_SCK: U8.2 (SCK)
SPI5_BARO_CS: U15.2 (CSB)
SPI5_BARO_MISO: U15.5 (SDO)
SPI5_BARO_MOSI: U15.3 (SDI)
SPI5_BARO_SCK: U15.4 (SCK)
SPI6_MAG_CS: U9.A5 (CSB)
SPI6_MAG_MISO: U9.B4 (SDI)
SPI6_MAG_MOSI: U9.C1 (SDO)
SPI6_MAG_SCK: U9.A3 (SCK)

Notes on the sheet:
Barometer — BMP280
Level Shifter
Do not put traces or vias underneath the sensor package.
keep the pressure port unobstructed avoid mechanical stress don't put noisy/high-current traces underneath/around the sensor
INT1(Pin 4) — signals the master to initiate SPI communication for updated sensor data
DO NOT PUT IT CLOSE TO: high-current power traces motor/ESC power circuitry large magnetic components
- 3-axis accelerometer - 3-axis gyroscope - SPI Communication Interface
Magnetometer — BMM150
LDO — (3V3 to 1V8)
IMU (ICM-42688-P)
SPI Bus (Shared): MOSI, MISO, SCK, CS (Used to move data)
100 nF capacitor extremely close to the VDD pin
IMU (ICM-20948)
IMU (ICM-42670-P)
• CSB: chip select, active low • SCK: serial clock • SDI: serial data input; data input/output in 3-wire mode (MOSI) • SDO: serial data output; hi-Z in 3-wire mode (MISO)
Converts 1V8 signal from ICM_20948 (IO) into 3V3 so that the MCU can communicate the data
Barometer — BMP388
