jahaanb7/Orion/Schematic/PowerSystem.kicad_sch

## KiCad design Schematic/PowerSystem.kicad_sch (2026-09-21)

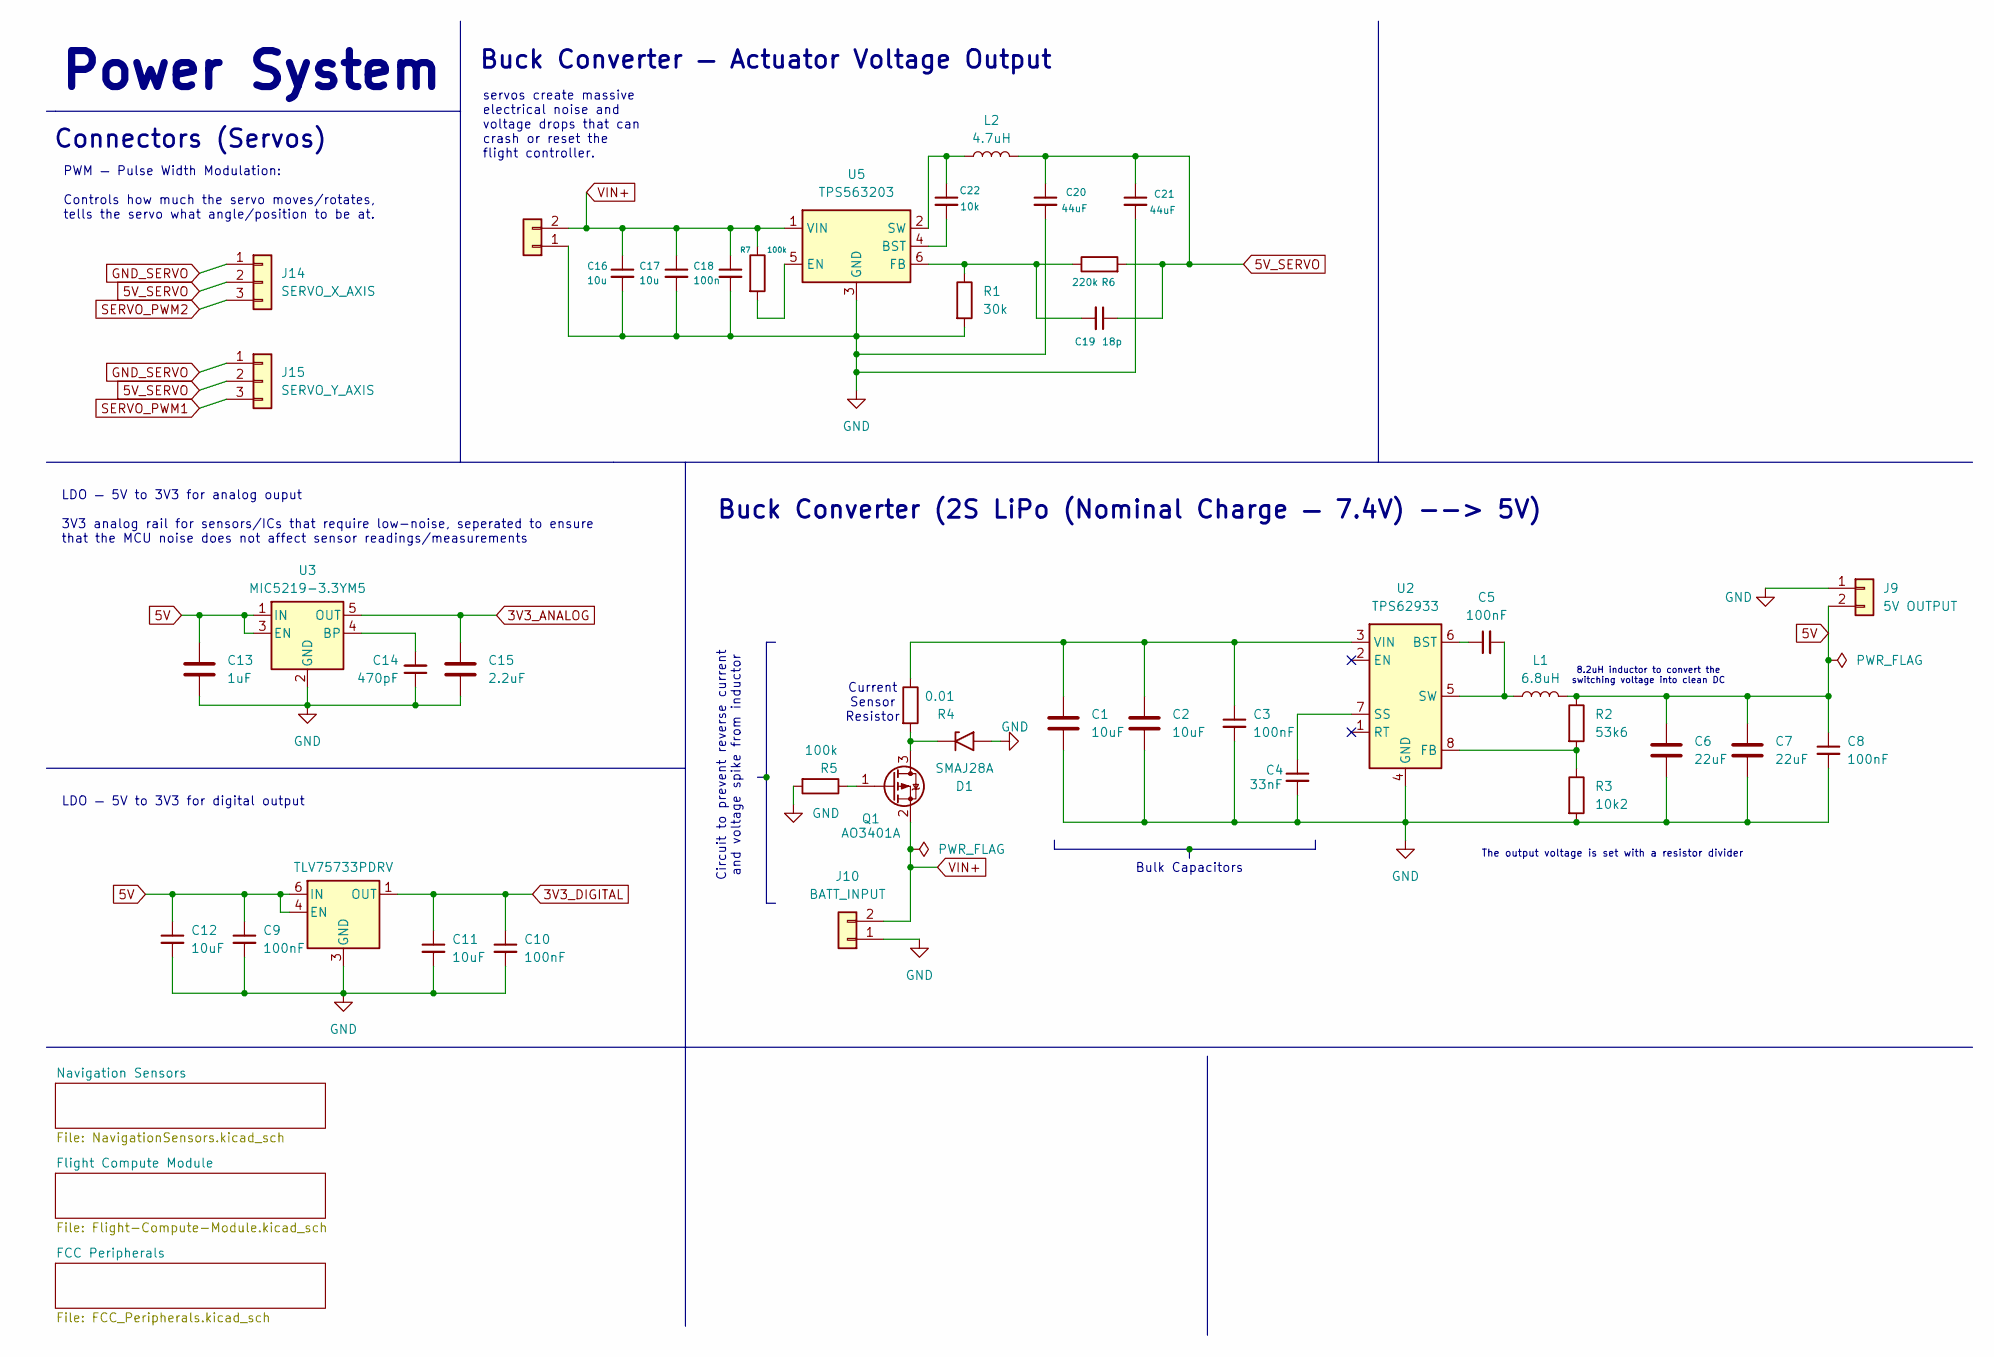
[picture p14: schematic PowerSystem.kicad_sch]

Parts:
C1, C2, C11, C12: 10uF
C3, C5, C8, C9, C10: 100nF
C4: 33nF
C6, C7: 22uF
C13: 1uF
C14: 470pF
C15: 2.2uF
C16, C17: 10u
C18: 100n
C19: 18p
C20, C21: 44uF
C22: 10k
D1: SMAJ28A; D_SMA
J9: 5V OUTPUT
J10, J11: BATT_INPUT
J14: SERVO_X_AXIS
J15: SERVO_Y_AXIS
L1: 6.8uH
L2: 4.7uH
Q1: AO3401A; SOT-23
R1: 30k
R2: 53k6
R3: 10k2
R4: 0.01
R5, R7: 100k
R6: 220k
U2: TPS62933; SOT-583-8
U3: MIC5219-3.3YM5; SOT-23-5
U4: TLV75733PDRV; WSON-6-1EP_2x2mm_P0.65mm_EP1x1.6mm
U5: TPS563203; SOT-563

Connections:
3V3_ANALOG: C15.1, U3.5 (OUT)
3V3_DIGITAL: C10.1, C11.1, U4.1 (OUT)
5V: C6.1, C7.1, C8.1, C9.1, C12.1, C13.1, J9.2, L1.2, R2.1, U3.1 (IN), U3.3 (EN), U4.4 (EN), U4.6 (IN)
5V_SERVO: C19.1, C20.1, C21.1, J14.2, J15.2, L2.2, R6.2
GND: C1.2, C2.2, C3.2, C4.2, C6.2, C7.2, C8.2, C9.2, C10.2, C11.2, C12.2, C13.2, C14.1, C15.2, C16.2, C17.2, C18.2, C20.2, C21.2, D1.2 (A2), J9.1, J10.1, J11.1, R1.2, R3.2, R5.2, U2.4 (GND), U3.2 (GND), U4.3 (GND), U4.7 (GND), U5.3 (GND)
GND_SERVO: J14.1, J15.1
unnamed: C1.1, C2.1, C3.1, R4.1, U2.3 (VIN)
unnamed: C4.1, U2.7 (SS)
unnamed: C5.1, U2.6 (BST)
unnamed: C5.2, L1.1, U2.5 (SW)
unnamed: C14.2, U3.4 (BP)
unnamed: C19.2, R1.1, R6.1, U5.6 (FB)
unnamed: C22.1, L2.1, U5.2 (SW)
unnamed: C22.2, U5.4 (BST)
unnamed: D1.1 (A1), Q1.3 (D), R4.2
unnamed: Q1.1 (G), R5.1
unnamed: R2.2, R3.1, U2.8 (FB)
unnamed: R7.2, U5.5 (EN)
SERVO_PWM1: J15.3
SERVO_PWM2: J14.3
VIN+: C16.1, C17.1, C18.1, J10.2, J11.2, Q1.2 (S), R7.1, U5.1 (VIN)

Notes on the sheet:
Circuit to prevent reverse current and voltage spike from inductor
PWM — Pulse Width Modulation: Controls how much the servo moves/rotates, tells the servo what angle/position to be at.
Connectors (Servos)
8.2uH inductor to convert the switching voltage into clean DC
Buck Converter — Actuator Voltage Output
LDO — 5V to 3V3 for analog ouput 3V3 analog rail for sensors/ICs that require low-noise, seperated to ensure that the MCU noise does not affect sensor readings/measurements
Current Sensor Resistor
LDO — 5V to 3V3 for digital output
Buck Converter (2S LiPo (Nominal Charge — 7.4V) --> 5V)
Power System
The output voltage is set with a resistor divider
Bulk Capacitors
servos create massive electrical noise and voltage drops that can crash or reset the flight controller.
