jahaanb7/Orion/(commit log)

2026-09-14 Revise README for Orion thrust-vector control rocket
    Updated project description and title to reflect new focus on thrust-vector control rocket.
2026-09-21 Rename Body Tubw.stl to CAD/Airframe/Body Tube.stl
    [Body Tube.stl]
2026-09-21 Rename Frame Structures.stl to CAD/Airframe/Frame Structures.stl
    [Frame Structures.stl]
2026-09-21 Rename Nose Cone.stl to CAD/Nose Cone.stl
    [Nose Cone.stl]
2026-09-21 Rename Support Structure.stl to CAD/Airframe/Support Structure.stl
    [Support Structure.stl]
2026-09-21 Create CAD
2026-09-21 Add Journal Entry 1 for ORION project
    Documented the first week of the ORION project, detailing the design and requirements for the model rocket, including power systems, navigation sensors, flight compute module, and CAD design.
2026-10-06 Sync Orion — Rocket Flight Controller from Half Life
